vmynick/TokenBlinker/media/social-preview.png

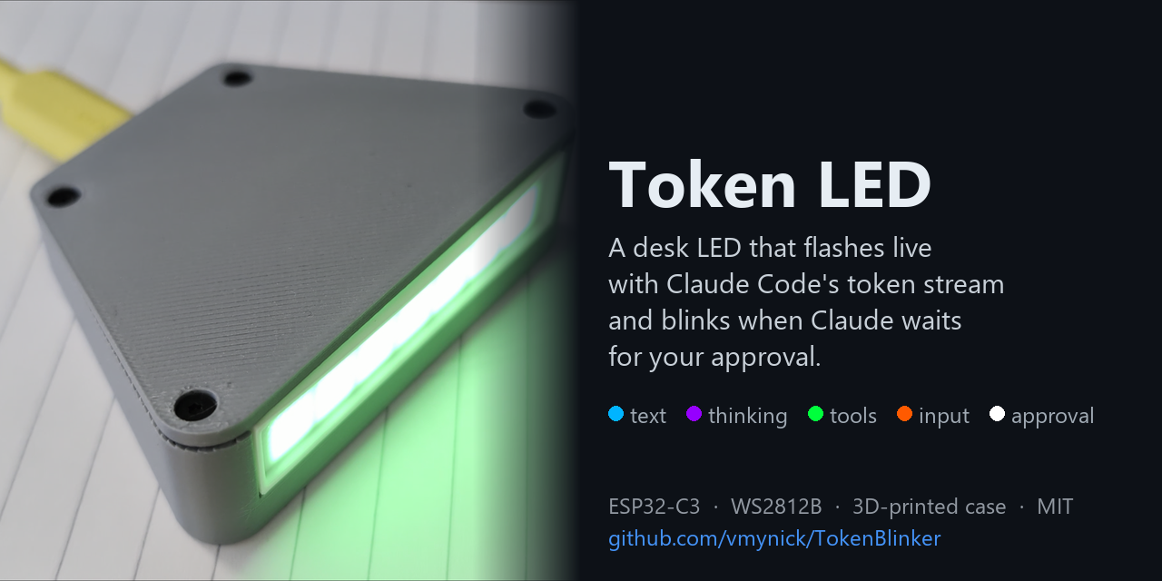
media/social-preview.png
