vmynick/TokenBlinker/enclosure/TokenLED_Box/baffle_P2S.stl

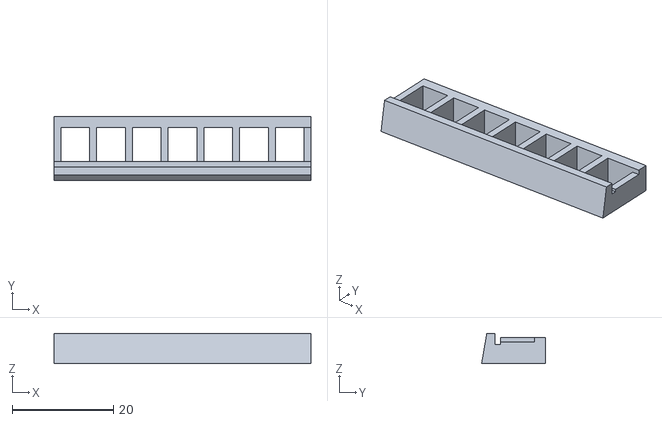
[picture p7: CAD file, 2026-10-28]
enclosure/TokenLED_Box/baffle_P2S.stl
50.7 x 12.6 x 6.00
