vmynick/TokenBlinker/enclosure/TokenLED_Box/TokenLED_Box_P2S.3mf

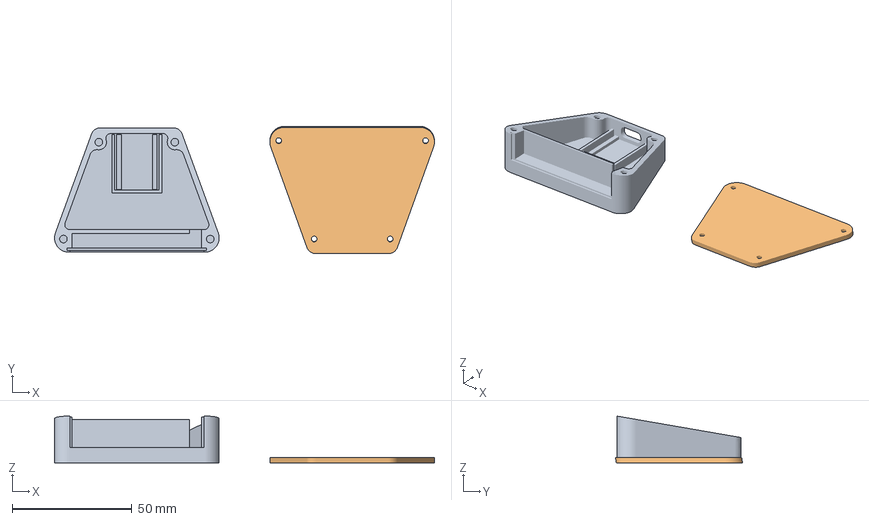
[picture p8: CAD file, 2026-10-28]
enclosure/TokenLED_Box/TokenLED_Box_P2S.3mf
158.8 x 53.2 x 19.6 mm
Base
Lid
