vmynick/TokenBlinker/enclosure/TokenLED_Box/TokenLED_Diffuser_P2S.3mf

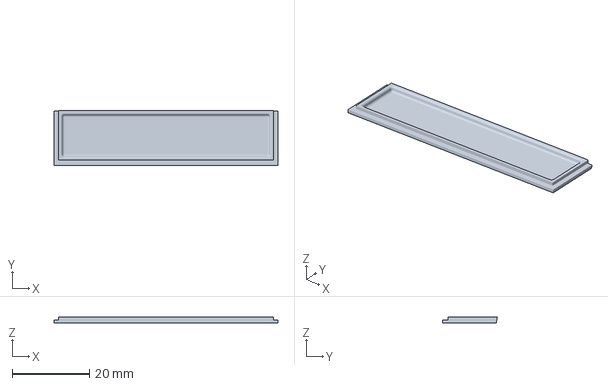
[picture p9: CAD file, 2026-10-28]
enclosure/TokenLED_Box/TokenLED_Diffuser_P2S.3mf
58.1 x 14.2 x 1.60 mm
