vmynick/TokenBlinker/enclosure/TokenLED_Box/base.stl

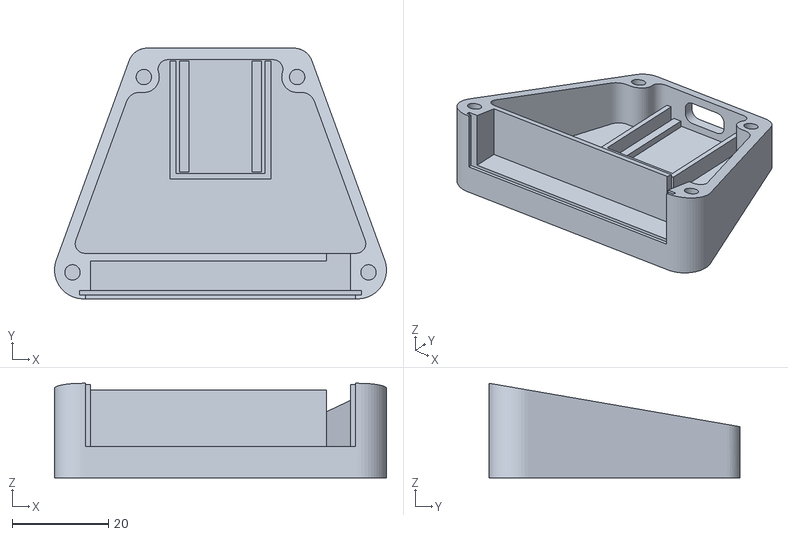
[picture p10: CAD file, 2026-10-28]
enclosure/TokenLED_Box/base.stl
68.8 x 52.0 x 19.6
