vmynick/TokenBlinker/enclosure/TokenLED_Box/lid.stl

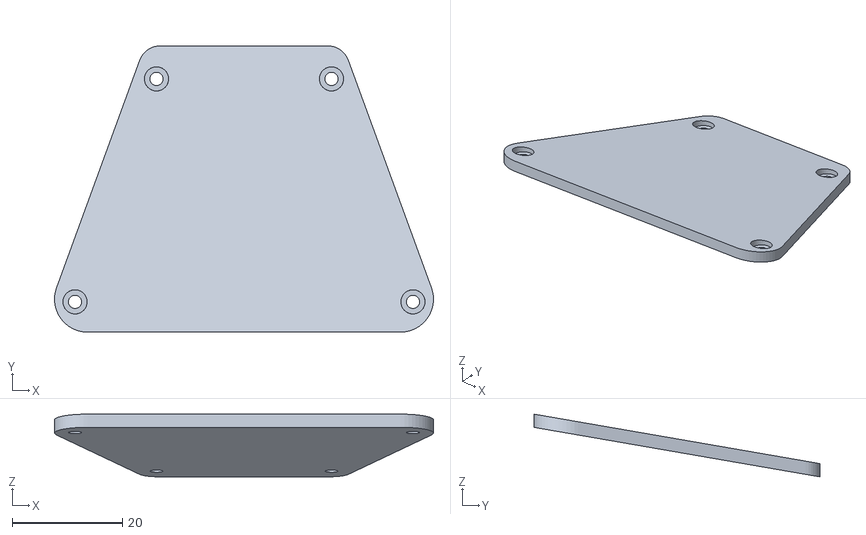
[picture p11: CAD file, 2026-10-27]
enclosure/TokenLED_Box/lid.stl
68.8 x 52.0 x 11.4
