vmynick/TokenBlinker/enclosure/TokenLED_Box/lid_P2S.stl

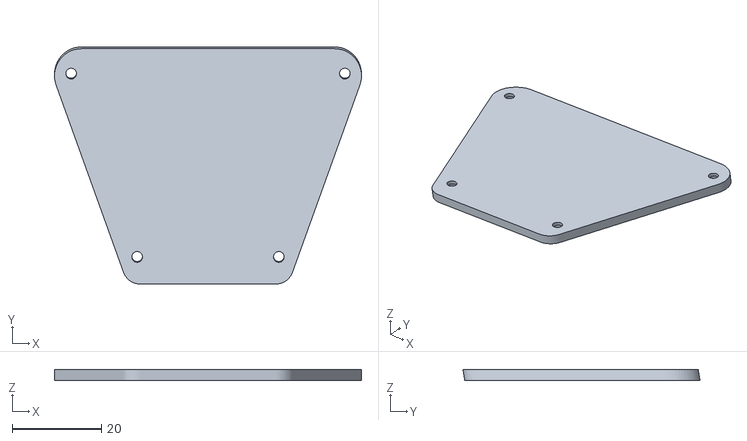
[picture p12: CAD file, 2026-10-27]
enclosure/TokenLED_Box/lid_P2S.stl
68.8 x 53.2 x 2.36
