vmynick/TokenBlinker/(list of files, cad)

Other CAD files:
enclosure/TokenLED_Box/baffle.stl
enclosure/TokenLED_Box/TokenLED_Baffle_P2S.3mf
enclosure/TokenLED_Box/base_P2S.stl
enclosure/TokenLED_Box/diffuser_P2S.stl
enclosure/TokenLED_Box/diffuser.stl
enclosure/TokenLED_Box/TokenLED_Box.f3d
