vmynick/TokenBlinker/(commit log)

2026-10-26 Claude token LED: élő villogás ESP32-C3 SuperMini Plus-on
    - token_tap: indító a VS Code Claude-bővítményhez (claudeProcessWrapper);
    a claude.exe kimenetéből élőben küldi a tokeneket UDP-n, proxy nélkül
    - firmware: WiFi + USB, nyers tokenekből villan, webes beállítófelület
    (http://tokenled.local), elemes üzemhez energiatakarékos WiFi
    - token_blinker.py: WiFi-beállítás USB-n, színteszt, naplóalapú számolás
    terminálos munkamenetekhez
2026-10-27 Webes felület: élő virtuális LED-ek és számlálók típusonként
2026-10-27 Állítható LED-szám és adatláb a webes felületen
2026-10-27 English by default, LED per type, approval signal
    - Web page and all active code/docs in English
    - Per-type LED assignment (auto: own LED per type from 5 LEDs up)
    - token_tap detects Claude's approval requests; the LED blinks white until answered
2026-10-27 Separate outputs for the onboard LED (GPIO8) and an external strip (own pin, default GPIO4)
2026-10-27 Per-type colours and multi-LED lists (1,3,5-8 / all)
2026-10-27 Approval reminder, 24 h chart, BOOT button, settings backup/restore
2026-10-27 Onboard LED options (brightness, shown functions, signal, usage colour), sectioned System page
2026-10-27 Fusion 360 script for the enclosure (wedge box, USB-C + LED window, M2 heat-set inserts, rubber feet)
2026-10-27 Enclosure concept A in Fusion 360: trapezoid wedge, USB-C at the back, corner-joined screw posts, P2S plate
2026-10-27 Enclosure: LED bay with wire slot, slide-in flush diffuser, black light baffle
    - the strip stands in a bay behind the front; its wires go back through a slot (open at the top) in the bay's back wall
    - separate white diffuser slides down from the top, flush with the front face, held by lips and the lid
    - separate black baffle with one cell per LED, its walls reach between the LEDs and its top bar holds the strip
    - base clipped to the rounded outline (corner fills poked out of the acute front corners)
    - one P2S 3MF per filament colour
2026-10-27 Enclosure: measured LED strip, baffle walls with 0.35 mm play, 2 mm room at the strip ends
    LEDs 4.97 mm with 2.08 mm gaps (pitch 7.05), strip 9.84 mm wide. The baffle wall is now
    LED_GAP - 2 x BAFFLE_CLR (1.38 mm). The bay is 54 mm long, which needs a 74 mm front
    (was 70) to keep 2.1 mm between the bay and the front insert holes. New layout check:
    the diffuser band must stay on the flat part of the front between the acute rounded corners.
2026-10-28 Live thinking flashes from redacted thinking, onboard LED type (RGB / plain), optional buzzer
    - token_tap: redacted thinking streams no text, only estimated_tokens in each
    thinking_delta; count those so the LED flashes while Claude thinks
    - Onboard LED type: WS2812B, or a plain LED lit on LOW / HIGH (PWM brightness)
    - Onboard brightness percentage now applies right after power-on
    - Buzzer on its own GPIO (active or passive): approval wait silent / one beep /
    beep until answered, optional click with every flash, silent at night and in quiet mode
2026-10-28 Enclosure v5 from Fusion: recessed diffuser window, baffle bar under the LEDs, rounded base corners
    Hand edits made in Fusion on top of the script's output, saved as TokenLED_Box.f3d.
    - Diffuser: light window recessed 1.2 mm from the front, 0.4 mm thick in front of the LEDs
    - Baffle: lower bar fills the space under each LED, walls cut back at the strip's
    upper edge, end walls adjusted (right one short for the wires)
    - Base: rounded inner front corners
    STLs, print-orientation STLs and P2S plates regenerated; README notes the
    changed assembly step for the baffle.
2026-10-28 Usage reset times on the Live page, enclosure pictures in the README
    - token_tap sends the 5-hour and 7-day reset times from rate_limit_event
    ("U <5h%> <7d%> <5h reset> <7d reset>"); the firmware still accepts the old two-field line
    - Live page: "Resets 12:30 (in 3 h 27 min)" under each usage bar, in the browser's time zone
    - README: front, back, open and exploded views of the enclosure (enclosure/img)
2026-10-28 Ready to share: web installer, macOS/Linux launcher, quick start, MIT licence, baffle clearance
    - docs/: web installer (GitHub Pages + ESP Web Tools) with the full 1.0.0 image
    - token_tap.py: the launcher for macOS and Linux, same behaviour as token_tap.exe
    - README: quick start (parts, install, WiFi, VS Code setting), file list
    - Firmware 1.0.0: version shown on the System page
    - Baffle: bar under the LEDs 0.3 mm lower so it slides in (Fusion v6, STL, plate, f3d)
    - media/social-preview.png for the repository's link preview
    - MIT licence
2026-11-06 Claude Code skill and plugin: set up, test, configure and troubleshoot the LED
    skills/tokenblinker/ is an Agent Skill; .claude-plugin/ makes the repository a
    plugin marketplace (/plugin install tokenblinker --marketplace vmynick/TokenBlinker).
    scripts/tokenled.py (standard library only): status, test flashes confirmed by
    the LED's counters, settings by name with an undo line, launcher install to
    ~/.tokenblinker (Windows: compiled locally from token_tap.cs), a self-test
    (byte-for-byte pass-through, exit code, fail-open with the LED unreachable, a real
    signal to the LED) that has to pass before the VS Code setting is written, and a
    doctor. scripts/ also holds copies of token_tap.py, token_tap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
